Taro-Hayashi/wheelcon/README.md

# Wheel con 取り扱い説明書([English](README_EN.md))

## 内容品
- Wheel con... 1個
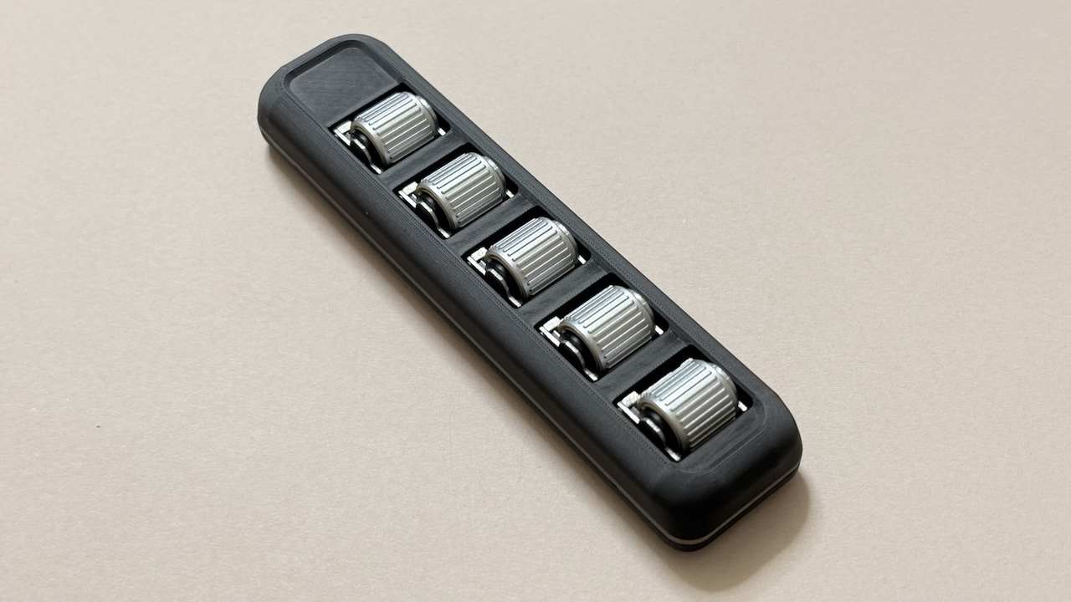
[picture p1: img/IMG_5368.jpg]


## ご用意いただくもの
- Type-C USBケーブル
- Windows/Mac/Linux（iPad、Androidでも使用できますが設定ができません）

## 使用方法
Wheel conをPCに接続するとRPI-RP2というドライブとして認識されます。  


こちらのファイルをダウンロードしてそこにドラッグ&ドロップしてください。
- [tarohayashi_wheel_con_via.uf2](https://github.com/Taro-Hayashi/wheelcon/releases/latest/download/tarohayashi_wheel_con_via.uf2)

自動的にRPI-RP2ドライブが消えたら使用する準備は完了です。

## キーのカスタマイズ
キーのカスタマイズにはRemapをご利用いただけます。
- https://remap-keys.app

接続するとこのような画面になるので、入れ替えたいキーをドラッグ&ドロップしてFlashボタンを押すと設定が変更されます。
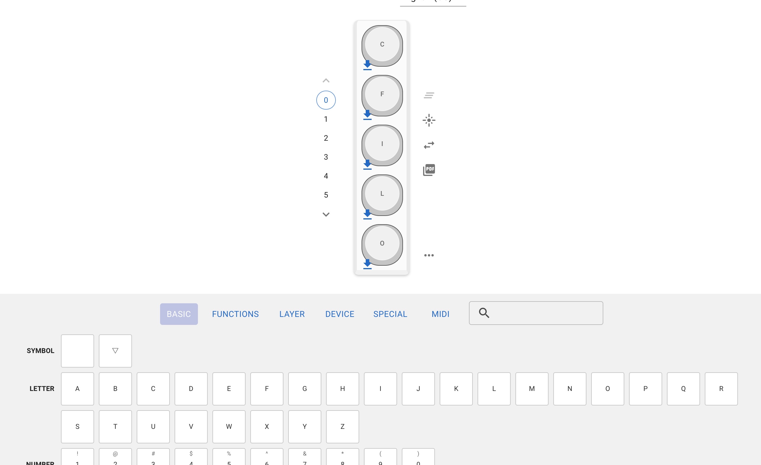
[picture p2: img/remap.jpg]


## Cintiq Pro用インチネジ取付部品の使い方

裏面のネジを外して基板を取り出します。
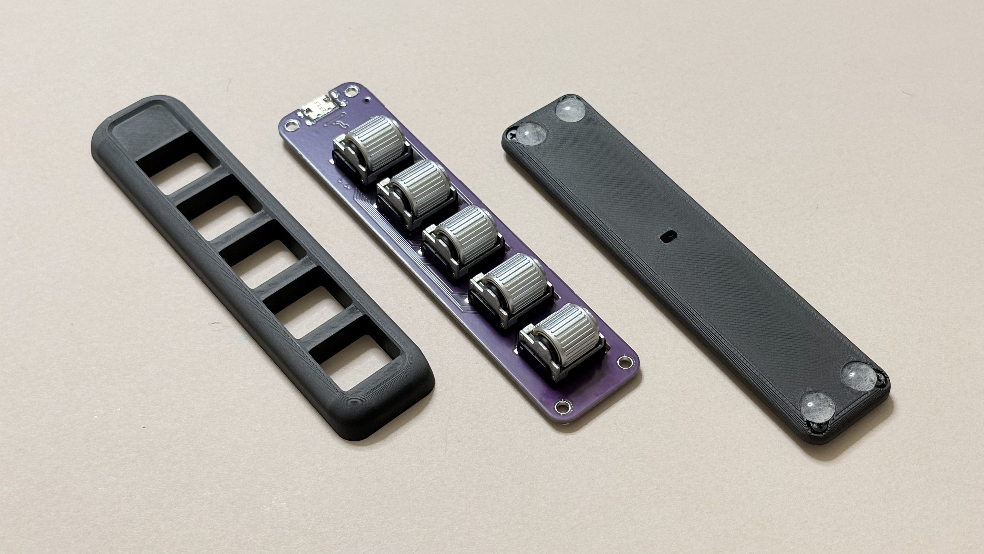
[picture p3: img/cintiq1.jpg]


ケース部品を付属のネジで取り付けます。上下を変えることでUSBケーブルの出し方を選ぶことができます。
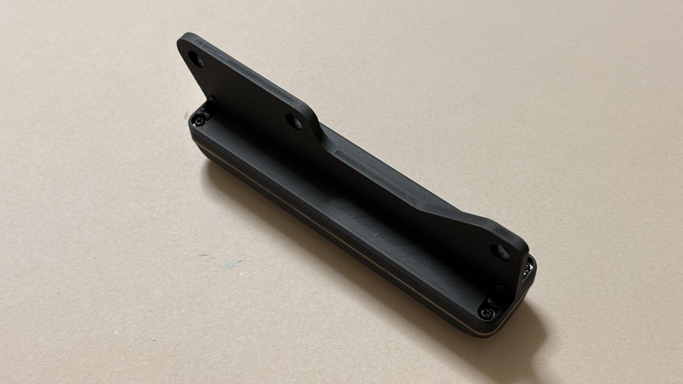
[picture p4: img/cintiq2.jpg]


取手付きのネジでCintiq Proに取り付けます。
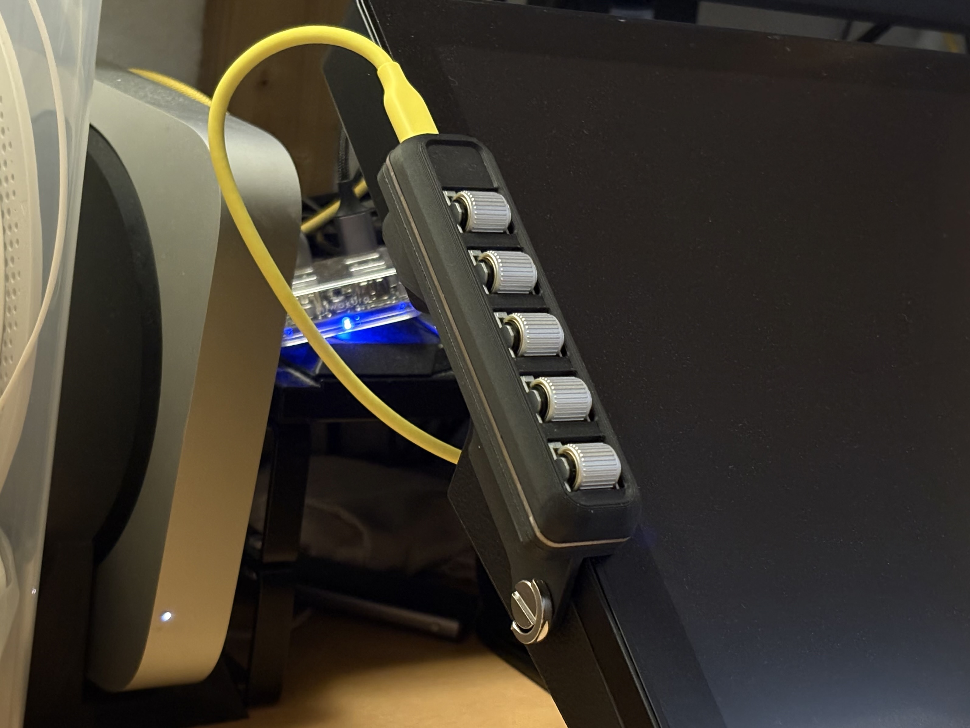
[picture p5: img/cintiq3.jpg]


## その他
### ファームウェアの更新方法
一番上のホイールを押し込みながらPCに接続するとRPI-RP2ドライブが出てくるのでそちらに新しいファームウェアをドラッグ&ドロップしてください。

### 出荷状態へのリセット方法
基板裏面のボタンを押しながらPCに接続するとRPI-RP2ドライブが出てきます。
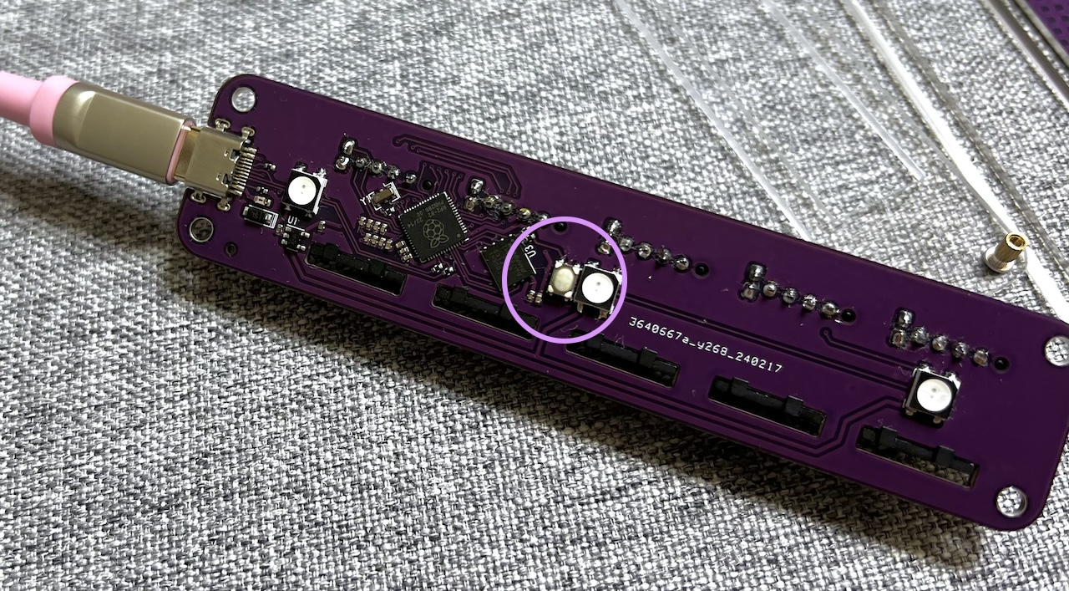
[picture p6: img/IMG_2667.jpg]


こちらのページの一番下の項目からflash_nuke.uf2をダウンロードしてドラッグアンドドロップしてください。
- https://www.raspberrypi.com/documentation/microcontrollers/raspberry-pi-pico.html

一旦ドライブが消え、また現れたらリセット完了です。

### ファームウェアのソースコード
- https://github.com/Taro-Hayashi/qmk_firmware/tree/tarohayashi/keyboards/tarohayashi/_archive/wheel_con

### 謝辞
このキーボードは原型師のCKB様のアイデアをもとに依頼を受けて製作しました。
- https://twitter.com/miku1596

### 販売サイト
- BOOTH https://tarohayashi.booth.pm/items/5553379
