Taro-Hayashi/wheelcon/img/IMG_2659.jpg

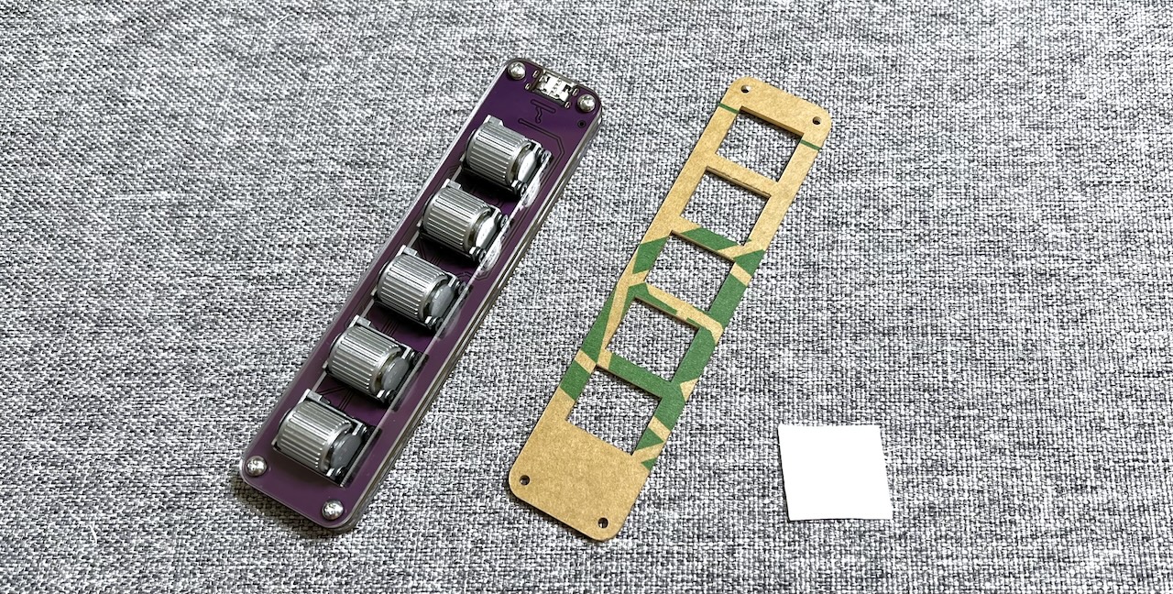
img/IMG_2659.jpg
