Taro-Hayashi/wheelcon/img/IMG_2672.jpg

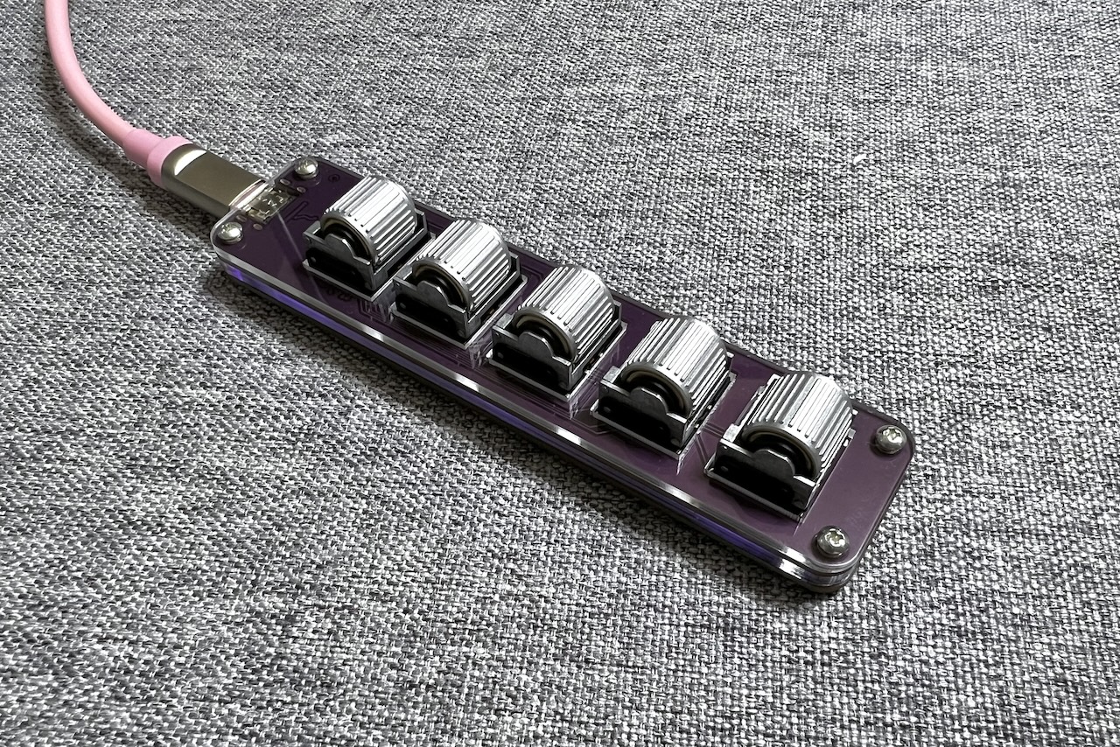
img/IMG_2672.jpg
