Taro-Hayashi/wheelcon/img/remap.png

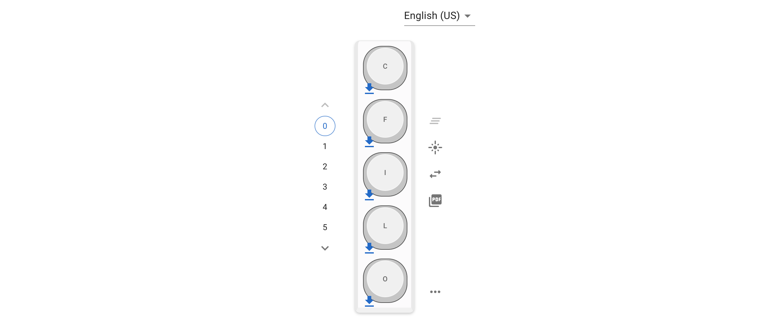
img/remap.png
