Taro-Hayashi/wheelcon/img/vial.png

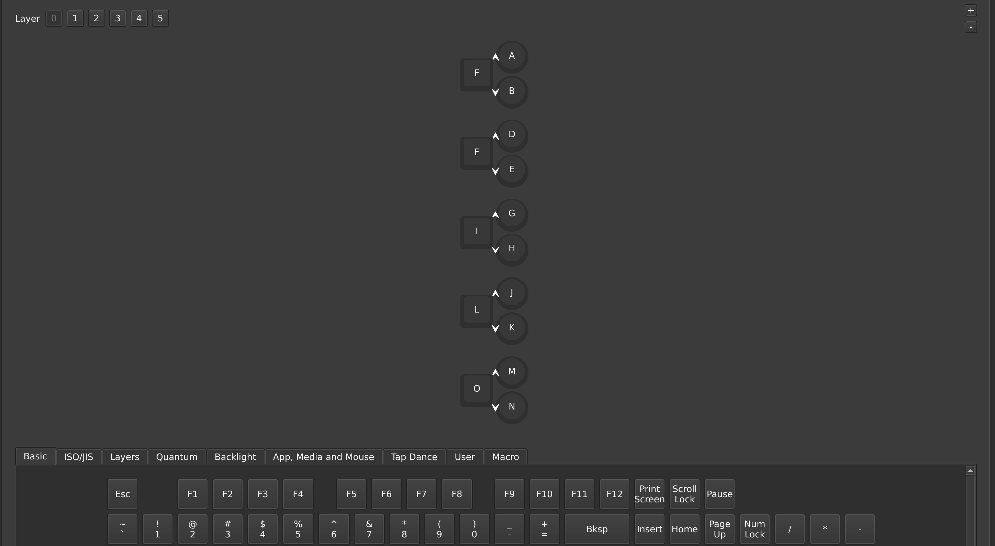
img/vial.png
