Taro-Hayashi/wheelcon/KiCad/test2.kicad_sch

## KiCad design KiCad/test2.kicad_sch (2026-05-24)

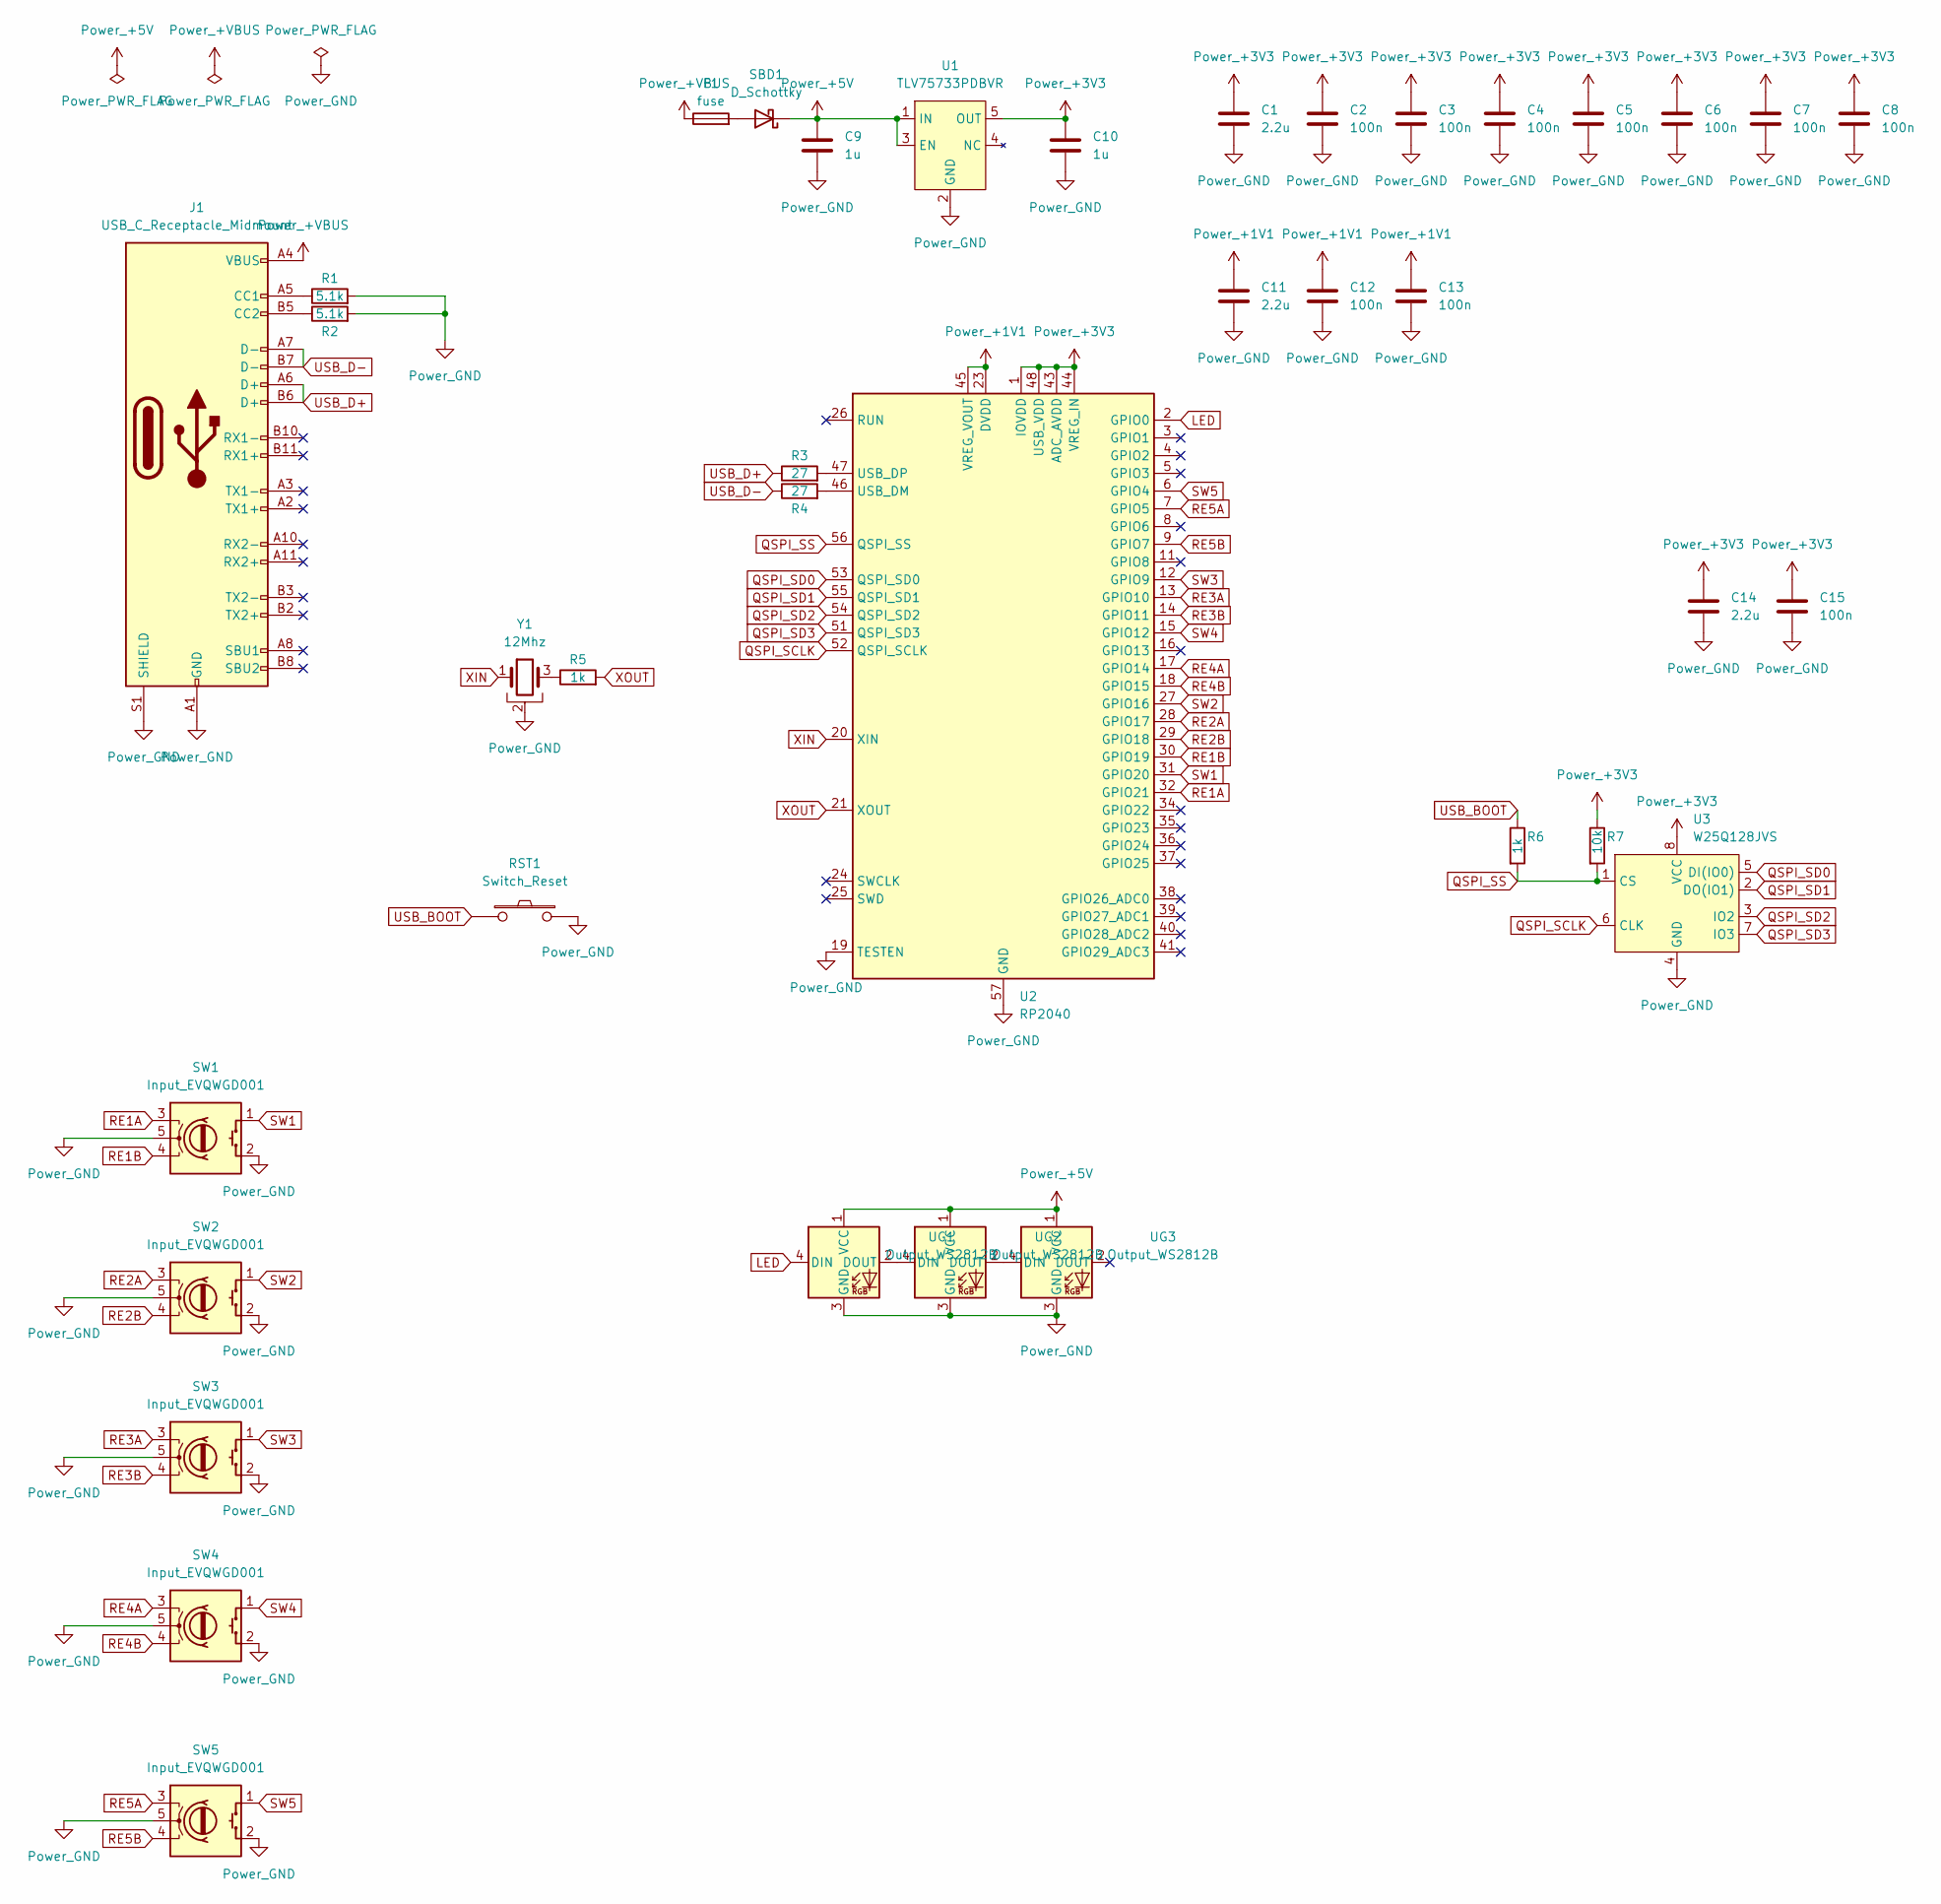
[picture p11: schematic test2.kicad_sch]

Parts:
C1, C11, C14: 2.2u; C_402; LCSC C307418
C2, C3, C4, C5, C6, C7, C8, C12, C13, C15: 100n; C_402; LCSC C1525
C9, C10: 1u; C_402; LCSC C52923
F1: fuse; Fuse_0603; LCSC C210357
J1: USB_C_Receptacle_Midmount; Type-C-Receptacle-Midmount; LCSC C3019717
R1, R2: 5.1k; R_0402; LCSC C25905
R3, R4: 27; R_0402; LCSC C25100
R5, R6: 1k; R_0402; LCSC C11702
R7: 10k; R_0402; LCSC C25744
RST1: Switch_Reset; SMD_Switch_Reset
SBD1: D_Schottky; D_schottky_SOD-123; LCSC C8598
SW1, SW2, SW3, SW4, SW5: Input_EVQWGD001; Encoder_EVQWGD001
U1: TLV75733PDBVR; SOT-23-5; LCSC C485517
U2: RP2040; LCSC C2040
U3: W25Q128JVS; WSON-8-1EP_6x5mm_P1.27mm_EP3.4x4.3mm; LCSC C190862
UG1, UG2, UG3: Output_WS2812B; LED_WS2812B
Y1: 12Mhz; Resonator_SMD_Murata_CSTxExxV-3Pin_3.0x1.1mm; LCSC C341520

Connections:
LED: U2.2 (GPIO0), UG1.4 (DIN)
unnamed: F1.2, SBD1.2 (A)
unnamed: J1.A5 (CC1), R1.1
unnamed: J1.B5 (CC2), R2.1
unnamed: R3.2, U2.47 (USB_DP)
unnamed: R4.2, U2.46 (USB_DM)
unnamed: R5.1, Y1.3
unnamed: UG1.2 (DOUT), UG2.4 (DIN)
unnamed: UG2.2 (DOUT), UG3.4 (DIN)
Power_+1V1: C11.1, C12.1, C13.1, U2.23 (DVDD), U2.45 (VREG_VOUT), U2.50 (DVDD)
Power_+3V3: C1.1, C2.1, C3.1, C4.1, C5.1, C6.1, C7.1, C8.1, C10.1, C14.1, C15.1, R7.1, U1.5 (OUT), U2.1 (IOVDD), U2.10 (IOVDD), U2.22 (IOVDD), U2.33 (IOVDD), U2.42 (IOVDD), U2.43 (ADC_AVDD), U2.44 (VREG_IN), U2.48 (USB_VDD), U2.49 (IOVDD), U3.8 (VCC)
Power_+5V: C9.1, SBD1.1 (K), U1.1 (IN), U1.3 (EN), UG1.1 (VCC), UG2.1 (VCC), UG3.1 (VCC)
Power_+VBUS: F1.1, J1.A4 (VBUS), J1.A9 (VBUS), J1.B4 (VBUS), J1.B9 (VBUS)
Power_GND: C1.2, C2.2, C3.2, C4.2, C5.2, C6.2, C7.2, C8.2, C9.2, C10.2, C11.2, C12.2, C13.2, C14.2, C15.2, J1.A1 (GND), J1.A12 (GND), J1.B1 (GND), J1.B12 (GND), J1.S1 (SHIELD), R1.2, R2.2, RST1.2, SW1.2 (S2), SW1.5 (C), SW2.2 (S2), SW2.5 (C), SW3.2 (S2), SW3.5 (C), SW4.2 (S2), SW4.5 (C), SW5.2 (S2), SW5.5 (C), U1.2 (GND), U2.19 (TESTEN), U2.57 (GND), U3.4 (GND), UG1.3 (GND), UG2.3 (GND), UG3.3 (GND), Y1.2
QSPI_SCLK: U2.52 (QSPI_SCLK), U3.6 (CLK)
QSPI_SD0: U2.53 (QSPI_SD0), U3.5 (DI(IO0))
QSPI_SD1: U2.55 (QSPI_SD1), U3.2 (DO(IO1))
QSPI_SD2: U2.54 (QSPI_SD2), U3.3 (IO2)
QSPI_SD3: U2.51 (QSPI_SD3), U3.7 (IO3)
QSPI_SS: R6.2, R7.2, U2.56 (QSPI_SS), U3.1 (CS)
RE1A: SW1.3 (A), U2.32 (GPIO21)
RE1B: SW1.4 (B), U2.30 (GPIO19)
RE2A: SW2.3 (A), U2.28 (GPIO17)
RE2B: SW2.4 (B), U2.29 (GPIO18)
RE3A: SW3.3 (A), U2.13 (GPIO10)
RE3B: SW3.4 (B), U2.14 (GPIO11)
RE4A: SW4.3 (A), U2.17 (GPIO14)
RE4B: SW4.4 (B), U2.18 (GPIO15)
RE5A: SW5.3 (A), U2.7 (GPIO5)
RE5B: SW5.4 (B), U2.9 (GPIO7)
SW1: SW1.1 (S1), U2.31 (GPIO20)
SW2: SW2.1 (S1), U2.27 (GPIO16)
SW3: SW3.1 (S1), U2.12 (GPIO9)
SW4: SW4.1 (S1), U2.15 (GPIO12)
SW5: SW5.1 (S1), U2.6 (GPIO4)
USB_BOOT: R6.1, RST1.1
USB_D+: J1.A6 (D+), J1.B6 (D+), R3.1
USB_D-: J1.A7 (D-), J1.B7 (D-), R4.1
XIN: U2.20 (XIN), Y1.1
XOUT: R5.2, U2.21 (XOUT)
