Taro-Hayashi/wheelcon/(commit log)

2025-12-27 Update source link for wheel_con in README_EN.md
2026-05-24 Add hardware and firmware files
    [acrylic_2mm.kicad_pcb, acrylic_3mm.kicad_pcb, bom.csv, designators.csv, positions.csv, test2.kicad_pcb, test2.kicad_sch]
